adrianntz/Proiect-Stabilizator-ERS/README.md

# Proiect-Stabilizator-ERS
Proiect universitar creeat cu scopul de a studia proiectarea unui stabilizator de tensiune cu element de reglaj serie.
