adrianntz/Proiect-Stabilizator-ERS/Schematics/Schematic.jpg

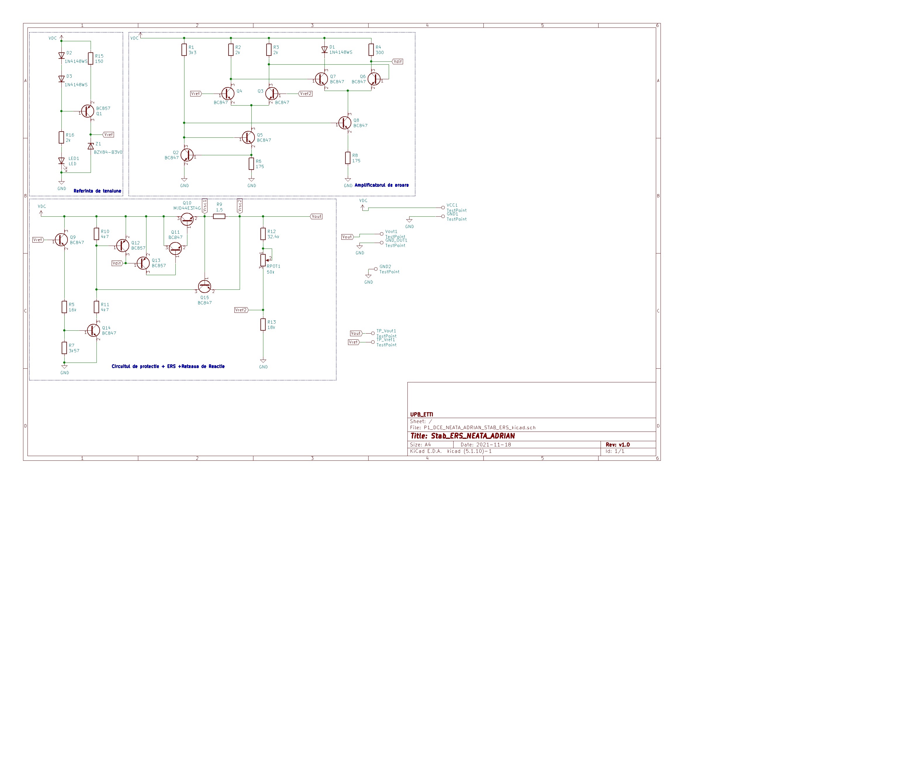
Schematics/Schematic.jpg
