adrianntz/Proiect-Stabilizator-ERS/Bill_of_materials/BOM si cerinte tehnologice.pdf

Componenta | Footprint | Power rating[mW] | Valoare | Producator | Pret unitar[L ei] | Pret total [Lei] | Componenta aleasa
D2,D3 | SOD-323FL | 200 | PN-Diode | ONSEMI | 1.38 | 6.9 | 1N4148WS – (https://ro.farnell.com/on-semiconductor/1n4148ws/diode-small-signal-75v-sod-323f/dp/2453269?st=1n4148) 200mW
T1 | SOT-23 | 250 | PNP | MULTICOMP PRO | 0.56 | 2.8 | BC857 – 250mW (https://ro.farnell.com/multicomp/bc857/transistor-pnp-0-1a-45v-sot23/dp/1798067?st=bc857)
R16 | 0805 | 125 | 30k | PANASONIC | 0.5 | 5 | ERJ6ENF3002V – 30kohm-125mW (https://ro.farnell.com/panasonic/erj6enf3002v/res-30k-1-0-125w-0805-thick-film/dp/2303701)
R15 | 0805 | 125 | 100 | MULTICOMP PRO | 1.65 | 16.5 | MCTC0525B1000T5 G - SMD 100 ohm, ± 0.1% (https://ro.farnell.com/multicomp-pro/mctc0525b1000t5g/res-100r-0-1-0-125w-0805-thin/dp/1575573) 125mW
Z1 | 3V | 125 | 3.0V | NEXPERIA | 1.18 | 5.75 | BZX84-B3V0,215 – Zener 3 V, 250 mW (https://ro.farnell.com/nexperia/bzx84-b3v0-215/zener-diode-0-25w-3v-sot-23/dp/2575187?st=BZX84-B3V0,215)
R1 | 0805 | 500 | 3.3k | VISHAY | 1.55 | 15.5 | CRCW08053K30FK EAHP -3.3kohmi (https://ro.farnell.com/vishay/crcw08053k30fkeahp/res-3k3-1-0-5w-0805-thick-film/dp/1738966) 500mW
R2 | 0805 | 125 | 2k | MULTICOMP PRO | 0.05 | 0.5 | MCWR08X2001FTL - 2 kohm, ± 1% 125mW (https://ro.farnell.com/multicomp/mcwr08x2001ftl/res-2k-1-0-125w-0805-thick-film/dp/2447622)
R3 | 0805 | 125 | 2k | MULTICOMP PRO | | | MCWR08X2001FTL - 2 kohm, ± 1% 125mW (https://ro.farnell.com/multicomp/mcwr08x2001ftl/res-2k-1-0-125w-0805-thick-film/dp/2447622)
R4 | 0805 | 125 | 300 | MULTICOMP PRO | 0.05 | 0.5 | MCWR08X3000FTL – 300ohmi (https://ro.farnell.com/multicomp/mcwr08x3000ftl/res-300r-1-0-125w-thick-film/dp/2447633) 125mW

R8 | 0805 | 500 | 174 | PANASONIC | 0.4 | 4 | ERJP06F1740V - P 174 ohm, ± 1% 500mW (https://ro.farnell.com/panasonic/erjp06f1740v/res-174r-1-0-5w-0805-thick-film/dp/2326739)
R6 | 0805 | 500 | 174 | PANASONIC | | | ERJP06F1740V - P 174 ohm, ± 1% 500mW (https://ro.farnell.com/panasonic/erjp06f1740v/res-174r-1-0-5w-0805-thick-film/dp/2326739)
T2 | SOT-23 | 250 | NPN | MULTICOMP PRO | | | 250mW (https://ro.farnell.com/multicomp/bc847c/transistor-npn-sot-23/dp/1574344?st=bc847)
T3 | SOT-23 | 250 | NPN | MULTICOMP PRO | | | BC847C – NPN-250mW (https://ro.farnell.com/multicomp/bc847c/transistor-npn-sot-23/dp/1574344?st=bc847)
T4 | SOT-23 | 250 | NPN | MULTICOMP PRO | | | BC847C – NPN-250mW (https://ro.farnell.com/multicomp/bc847c/transistor-npn-sot-23/dp/1574344?st=bc847)
T5 | SOT-23 | 250 | NPN | MULTICOMP PRO | | | BC847C – NPN-250mW (https://ro.farnell.com/multicomp/bc847c/transistor-npn-sot-23/dp/1574344?st=bc847)
T6 | SOT-23 | 250 | NPN | MULTICOMP PRO | | | BC847C – NPN-250mW (https://ro.farnell.com/multicomp/bc847c/transistor-npn-sot-23/dp/1574344?st=bc847)
T7 | SOT-23 | 250 | NPN | MULTICOMP PRO | | | BC847C – NPN-250mW (https://ro.farnell.com/multicomp/bc847c/transistor-npn-sot-23/dp/1574344?st=bc847)
T8 | SOT-23 | 250 | NPN | MULTICOMP PRO | | | BC847C – NPN-250mW (https://ro.farnell.com/multicomp/bc847c/transistor-npn-sot-23/dp/1574344?st=bc847)
T13 | SOT-23 | 250 | NPN | MULTICOMP PRO | | | BC847C – NPN-250mW (https://ro.farnell.com/multicomp/bc847c/transistor-npn-sot-23/dp/1574344?st=bc847)
D1 | SOD-323FL | 200 | PN-Diode | ONSEMI | 1.38 | 0 | 1N4148WS – (https://ro.farnell.com/on-semiconductor/1n4148ws/diode-small-signal-75v-sod-323f/dp/2453269?st=1n4148) 200mW
0.65 | 7.15 | BC847C – NPN-

T10 | TO-252 (DPAK) | 200 | NPN-Power | ONSEMI | 4,85 | 24.2 5 | MJD44E3T4G -BJT (https://ro.farnell.com/on-semiconductor/mjd44e3t4g/transistor-npn-80v-10a-to-252/dp/2727980) NPN 20W SMD
P1 | :Potentiometer_ Vishay_TS53YL_ Vertical | 250 | 50k | VISHAY | 7.58 | 7.58 | TS53YL503MR10 VISHAY -Potenţiometru: de montare | singură tură; 50kΩ; (https://www.tme.eu/ro/details/ts53yl50k/trimere-smd-cu-o-singura-tura/vishay/ts53yl503mr10/)
R12 | 0805 | 100 | 32.4k | Holsworthy-TE connectivity | 2.76 | 27.6 | 1676305-3 -r, 32.4 kohm, ± 0.1% (farnell.com) (https://ro.farnell.com/holsworthy-te-connectivity/1676305-3/res-32k4-0-1-0-1w-0805-thin-film/dp/2992061)
R13 | 0805 | 100 | 18k | WALSIN | 0.68 | 6.8 | WF08U1802BTL -Walsin - SMD Chip Resistor, 18 kohm, ± 0.1% (farnell.com) (https://ro.farnell.com/walsin/wf08u1802btl/res-18k-0-1-100v-0805-thin-film/dp/2502875)
| | | | | | | - Multicomp Pro -SMD Chip Resistor, 4.7 kohm, ± 1% (farnell.com) (https://ro.farnell.com/multicomp/mcwr08x4701ftl/res-4k7-1-0-125w-0805-thick-film/dp/2447672) 125mW Thick Film
R11 | 0805 | 125 | 4.7k | | | | MCWR08X4701FTL - Multicomp Pro -SMD Chip Resistor, 4.7 kohm, ± 1% (farnell.com) (https://ro.farnell.com/multicomp/mcwr08x4701ftl/res-4k7-1-0-125w-0805-thick-film/dp/2447672) 125mW Thick Film
R10 | 0805 | 125 | 4.7k | MULTICOMP PRO | 0.05 | 0.5 | MCWR08X4701FTL

R5 | 0805 | 125 | 16k | PANASONIC | 1.85 | 18.5 | ERA6AEB163V -Panasonic - SMD Chip Resistor, 16 kohm, ± 0.1% (farnell.com)Thin (https://ro.farnell.com/panasonic/era6aeb163v/res-16k-0-1-0-125w-0805-metal/dp/1670243?st=era6aeb163v) Film
R7 | 0805 | 100 | 3.57k | TT ELECTRONICS | 1.76 | 1.76 | PCF0805R -3K57BT1 - Tt Electronics / Welwyn - SMD Chip Resistor, 3.57 kohm, ± 0.1% 100mW (https://ro.farnell.com/tt-electronics-welwyn/pcf0805r-3k57bt1/res-3k57-0-1-0-1w-0805-thin-film/dp/1353271) Thin Film
R9 | 0805 | 500 | 1.5 | | 0.43 | 4.30 | ERJUP6J1R5V -Panasonic - SMD Chip Resistor, 1.5 ohm, ± 5% (farnell.com) (https://ro.farnell.com/panasonic/erjup6j1r5v/res-1r5-5-0-5w-0805-thick-film/dp/3598234) Thick Film
T9 | SOT -23 | 250 | NPN | MULTICOMP PRO | 0.65 | 0 | BC847C – NPN -250mW (https://ro.farnell.com/multicomp/bc847c/transistor-npn-sot-23/dp/1574344?st=bc847)
T11 | SOT -23 | 250 | NPN | MULTICOMP PRO | 0.65 | 0 | BC847C – NPN -250mW (https://ro.farnell.com/multicomp/bc847c/transistor-npn-sot-23/dp/1574344?st=bc847)
T12 | SOT -23 | 250 | PNP | MULTICOMP PRO | 0.56 | 0 | BC857 – 250mW (https://ro.farnell.com/multicomp/bc857/transistor-pnp-0-1a-45v-sot23/dp/1798067?st=bc857)
T13 | SOT -23 | 250 | PNP | MULTICOMP PRO | 0.56 | 0 | BC857 – 250mW (https://ro.farnell.com/multicomp/bc857/transistor-pnp-0-1a-45v-sot23/dp/1798067?st=bc857)
T1 | SOT -23 | 250 | NPN | MULTICOMP PRO | 0.65 | 0 | BC847C – NPN -250mW (https://ro.farnell.com/multicomp/bc847c/transistor-npn-sot-23/dp/1574344?st=bc847)

T15 | SOT -23 | 250 | NPN | MULTICOMP PRO | 0.65 | 0 | BC847C – NPN -250mW (https://ro.farnell.com/multicomp/bc847c/transistor-npn-sot-23/dp/1574344?st=bc847)
LED1 | 0805 | 62.5mW | 20mA,2.2V | KINGBRIGHT | 0.95 | 4.75 | KPHCM -2012SGC -T - Kingbright - LED, Low Power, Green (farnell.com) (https://ro.farnell.com/kingbright/kphcm-2012sgc-t/led-0805-green-25mcd-568nm/dp/1686074?st=led%200805%20green)

# Cerinte tehnologice:

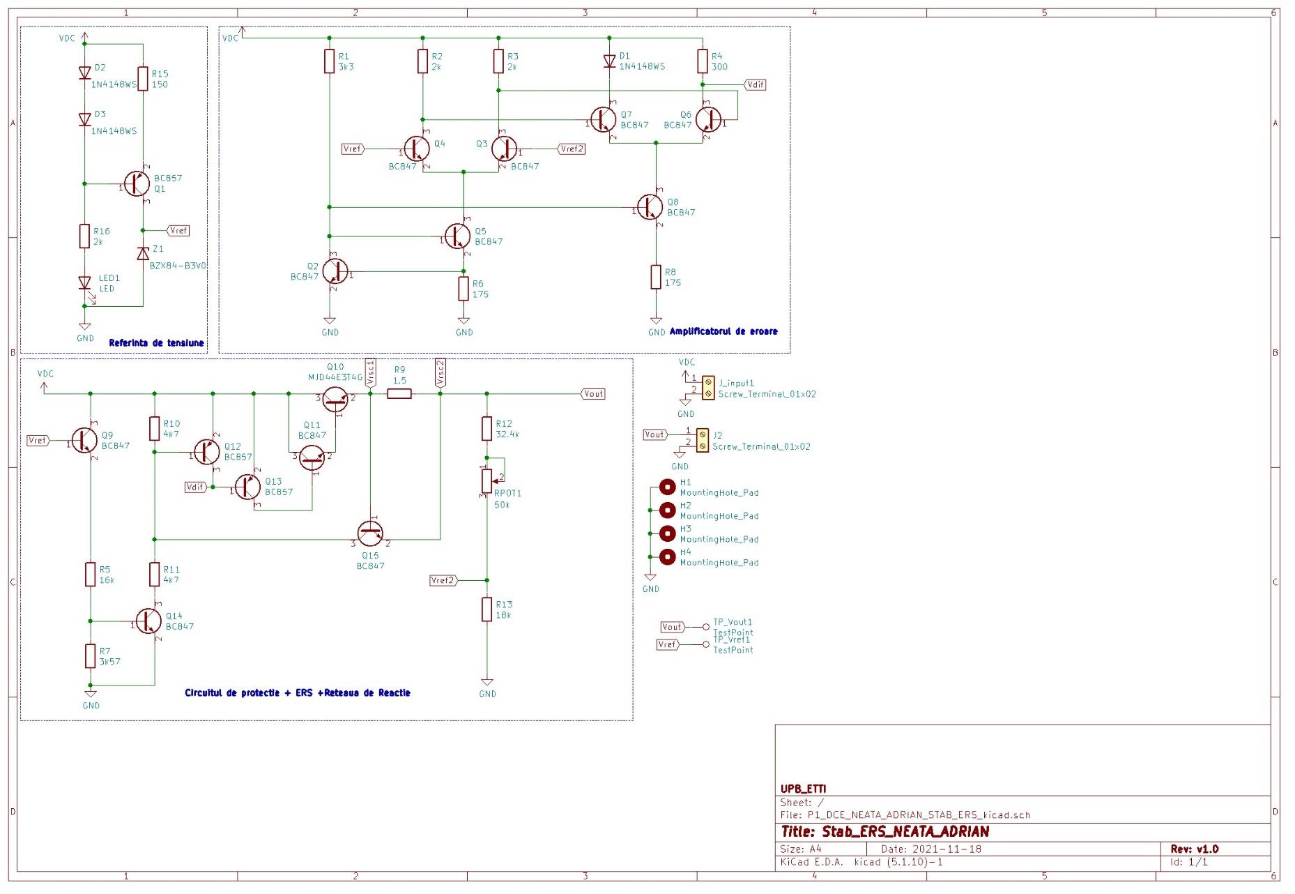
[picture p15: figure]

Schematic:

PCB-ul fizic in 3D view:

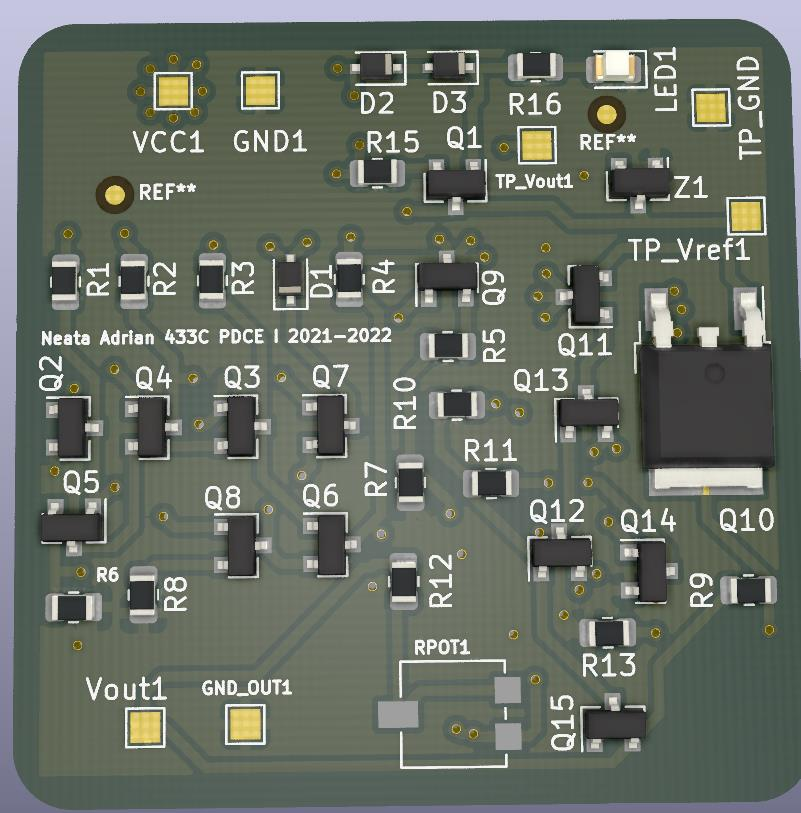
[picture p16: figure]

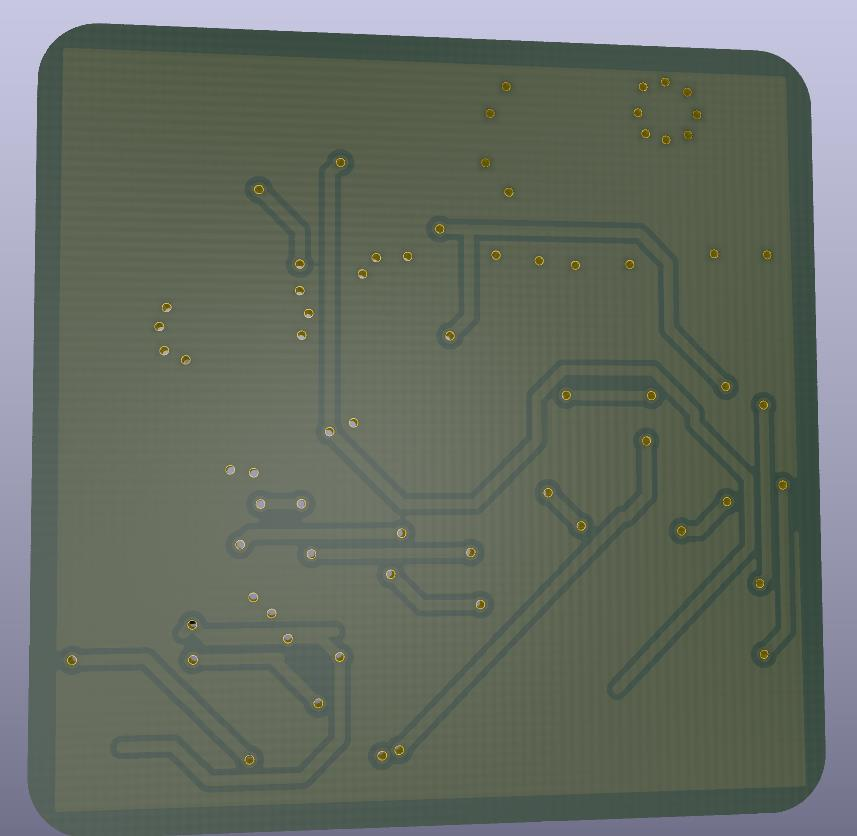
[picture p17: figure]

Dimensiunile PCB: 40mm x 40mm;

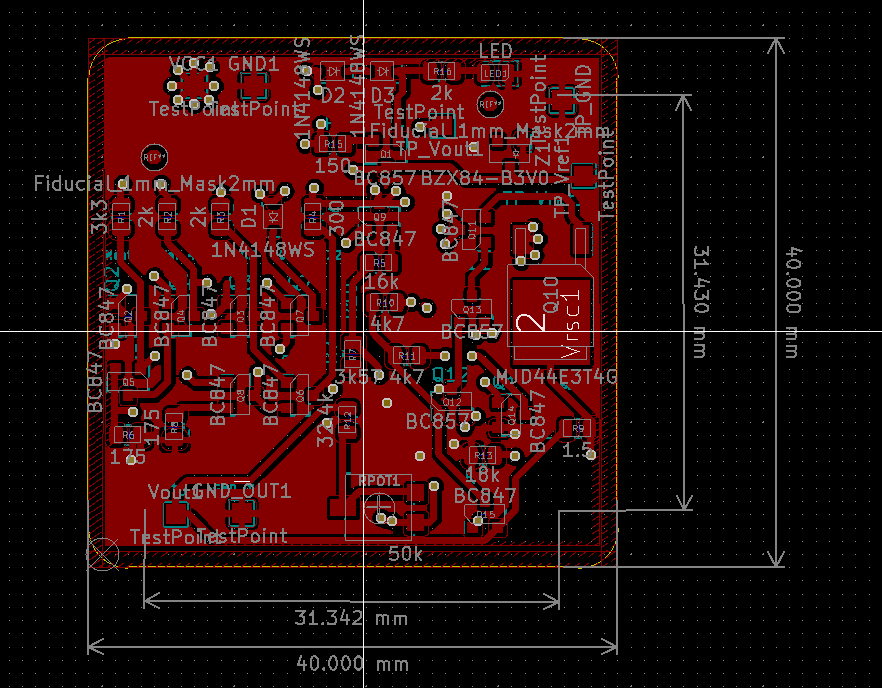
[picture p18: figure]

Material FR4, dublu strat/ grosimea foliei de cupru 18 μm, grosimea plăcii 1,5 mm;

Originea (punctul de coordonate (0,0)) va fi plasat în colţul din stânga-jos al plăcii de cablaj imprimat, astfel toate elementele proiectului vor avea coordonate pozitive;

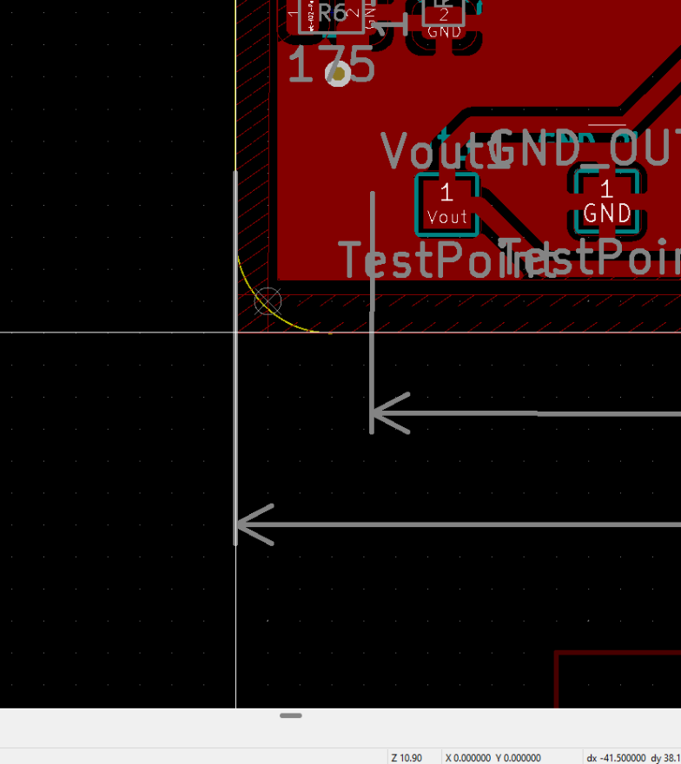
[picture p19: figure]
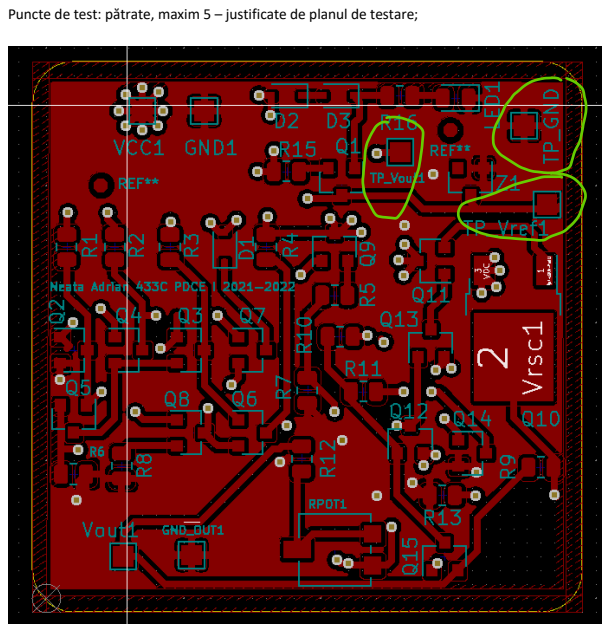
[picture p20: page 12]

Puncte de test: pătrate, maxim 5 – justificate de planul de testare;

Faţă de marginea plăcii, se va păstra o gardare („clearance”) de 1,2 mm; aici nu vor fi plasate componente, trasee, texte, etc.;

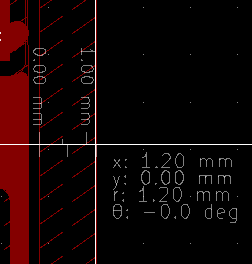
[picture p21: figure]

S-au introdus keep-out areas la marginea placii, avand lungime de 1.2mm

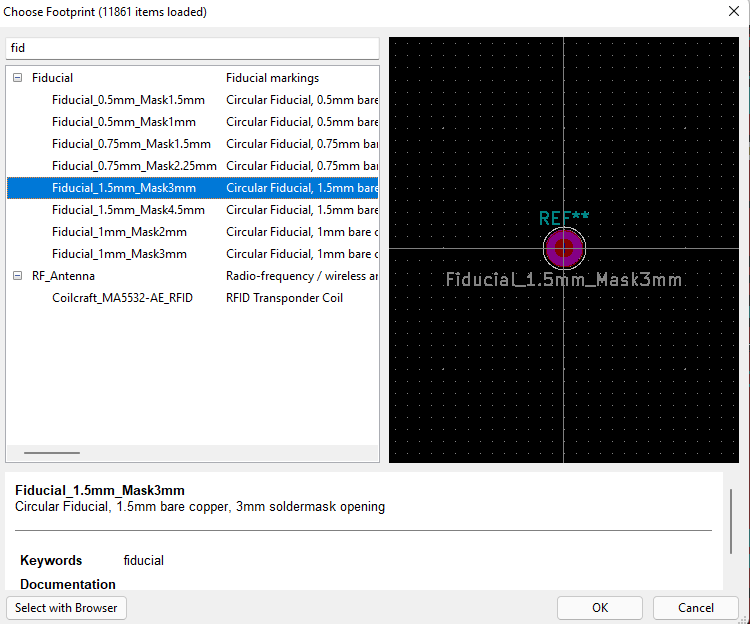
[picture p22: figure]

Placa va fi prevăzută cu 2 markeri fiduciali globali pe layerul TOP, la distanța de 200 mil față de marginea plăcii, plasați convenabil; acești markeri vor exista și pe layerul Solder Paste Top (suprapuși peste cei de pe TOP); vor fi utilizați în momentul alinierii șablonului cu placa. Marcajul fiducial va fi un cerc de diametru minim 1mm pe layerul respectiv, aflat într-un spațiu circular de diametru minim dublu față de cercul interior, în care nu se va afla nimic pe nici un layer;

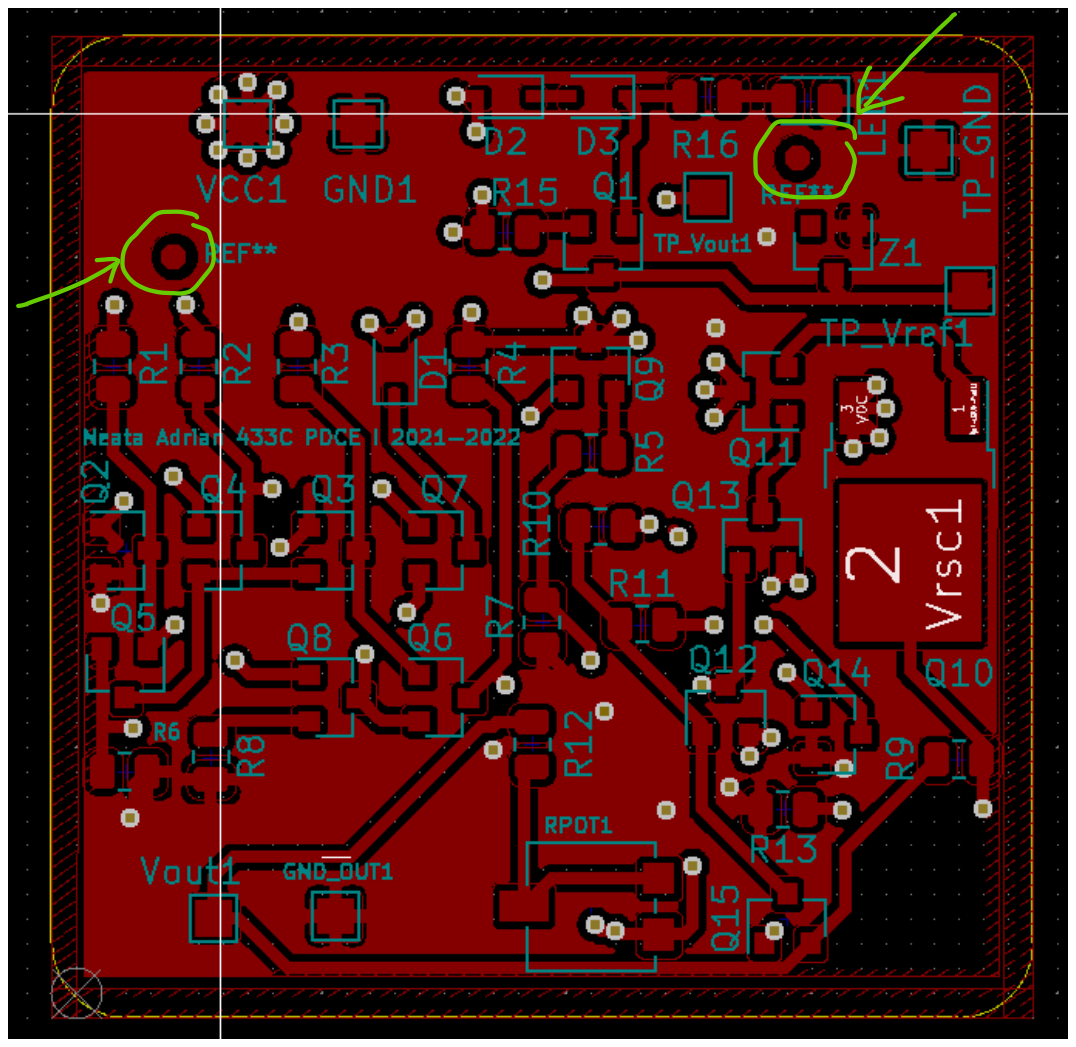
[picture p23: page 14]

Curent de sute de mA - 20 mil;

Găurile de trecere pentru semnale (vias-uri) vor avea diametrul de 0,4 mm.

Spaţierea, în toate cazurile, va fi de 12 mil.

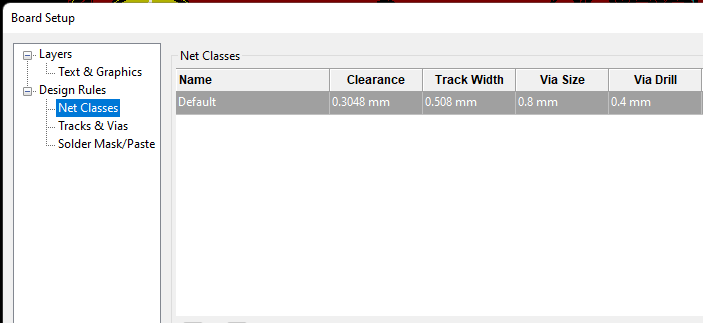
[picture p24: figure]

Fisierele Gerber:

Conturul plăcii (board outline);

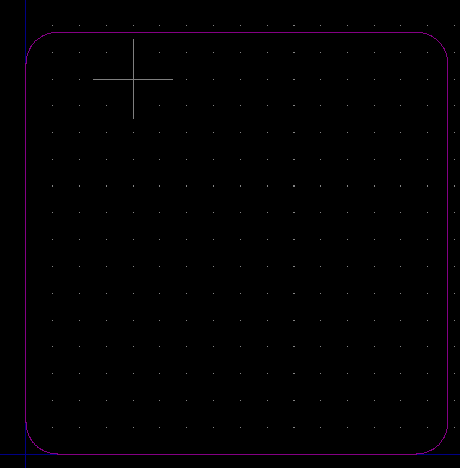
[picture p25: figure]

Layer electric TOP;

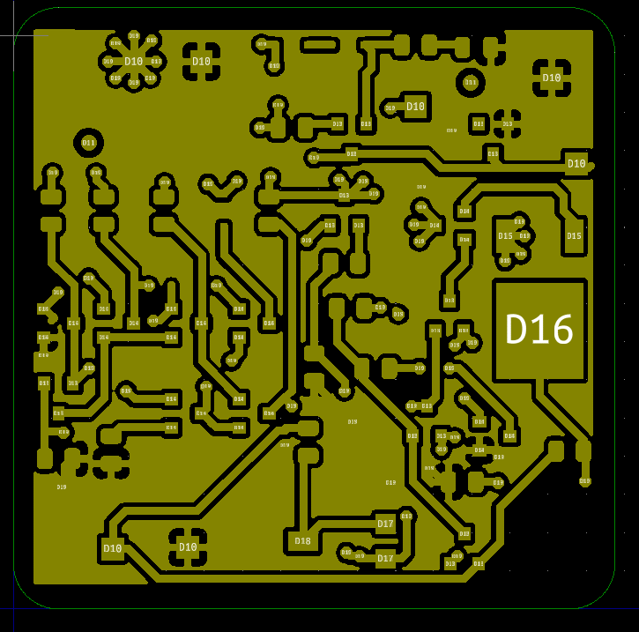
[picture p26: figure]

Layer electric BOTTOM;

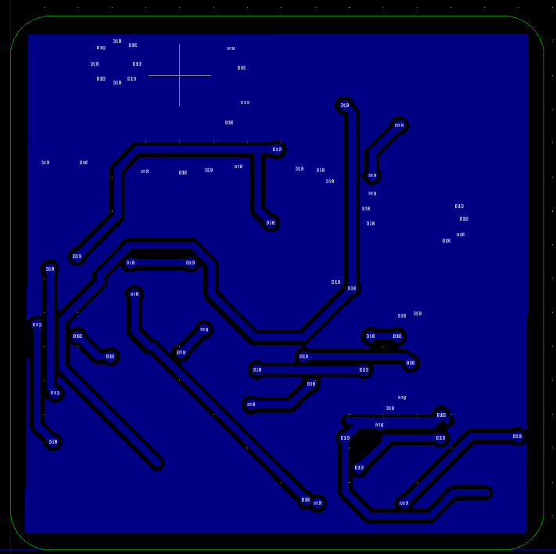
[picture p27: figure]

Layer neelectric Mască de inscripţionare (Silk Screen Top);

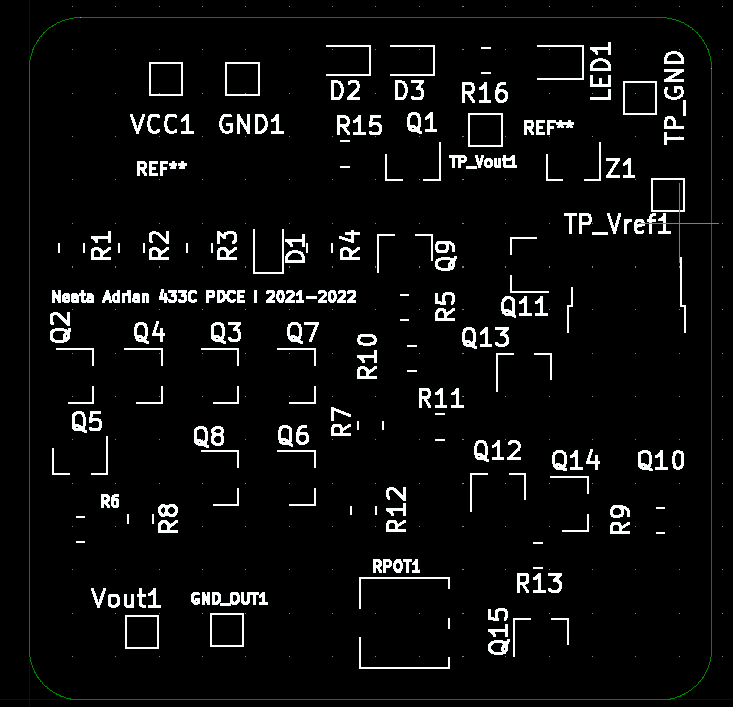
[picture p28: figure]

Layer neelectric Mască de protecţie (Solder Mask Top și Bottom);

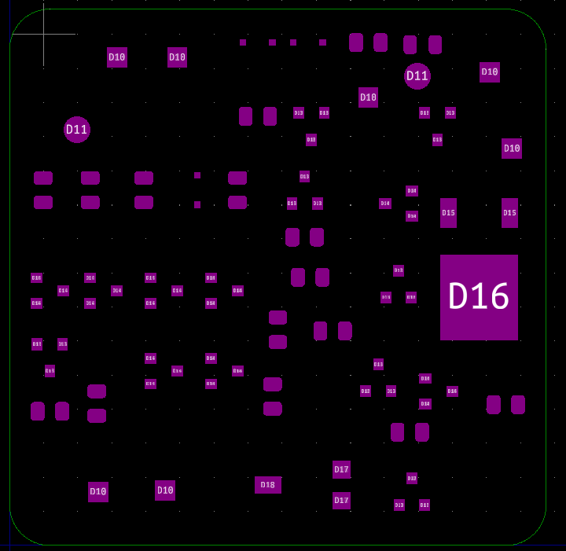
[picture p29: figure]

Layer neelectric Şablon (Solder Paste Top);

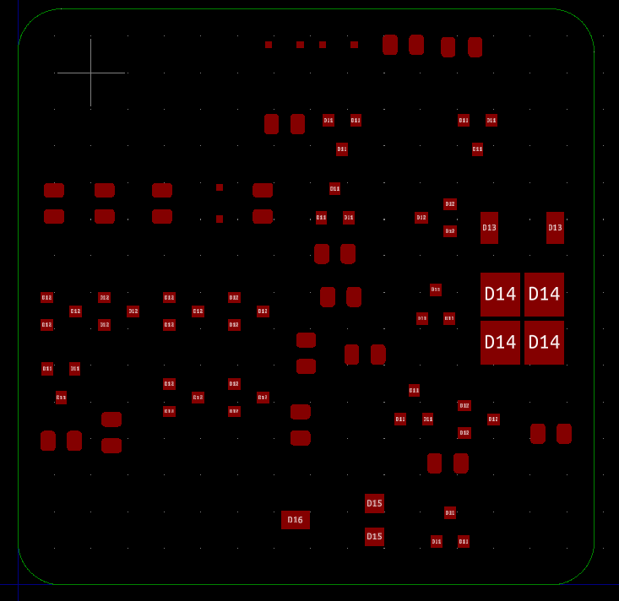
[picture p30: figure]

Fabrication

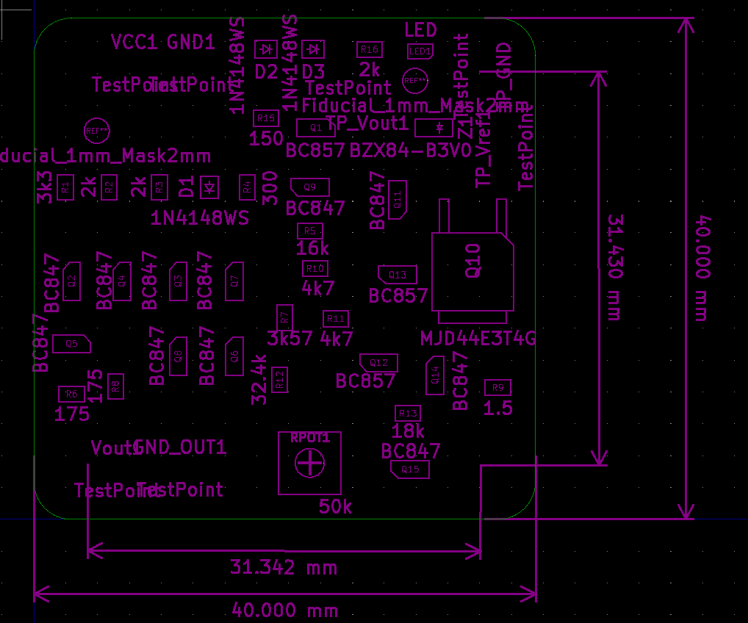
[picture p31: figure]

Drill map:

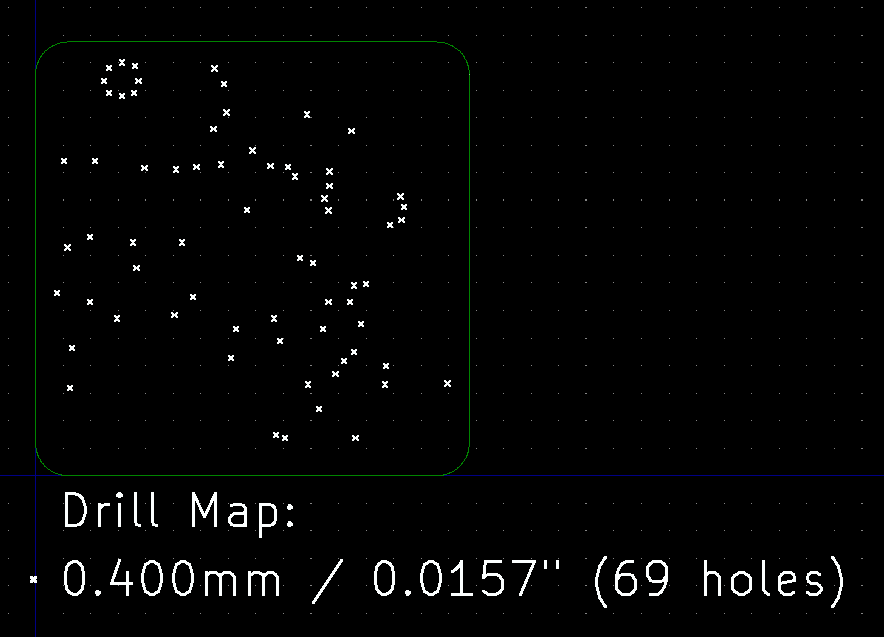
[picture p32: figure]
