adrianntz/Proiect-Stabilizator-ERS/Layout/Proiect_Kicad/P1_DCE_NEATA_ADRIAN_STAB_ERS_kicad.kicad_pcb

## KiCad design Layout/Proiect_Kicad/P1_DCE_NEATA_ADRIAN_STAB_ERS_kicad.kicad_pcb (2022-06-09)

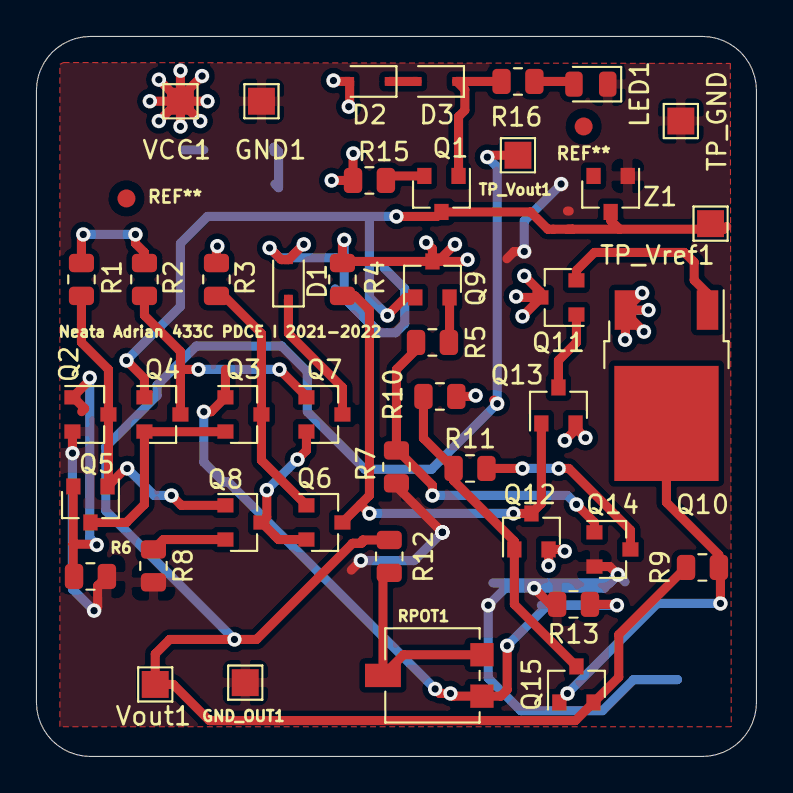
[picture p33: board P1_DCE_NEATA_ADRIAN_STAB_ERS_kicad.kicad_pcb from above]

Board: 2 copper layers, 40.0 x 40.0 mm, 43 parts (0 on the bottom side), 26 nets.

Parts:
D1, D2, D3: 1N4148WS; D_SOD-323F
GND1: TestPoint; TestPoint_Pad_1.5x1.5mm
GND_OUT1: TestPoint; TestPoint_Pad_1.5x1.5mm
LED1: LED; LED_0805_2012Metric
Q1, Q12, Q13: BC857; SOT-23
Q2, Q3, Q4, Q5, Q6, Q7, Q8, Q9, Q11, Q14, Q15: BC847; SOT-23
Q10: MJD44E3T4G; TO-252-2
R1: 3k3; R_0805_2012Metric
R2, R3, R16: 2k; R_0805_2012Metric
R4: 300; R_0805_2012Metric
R5: 16k; R_0805_2012Metric
R6, R8: 175; R_0805_2012Metric
R7: 3k57; R_0805_2012Metric
R9: 1.5; R_0805_2012Metric
R10, R11: 4k7; R_0805_2012Metric
R12: 32.4k; R_0805_2012Metric
R13: 18k; R_0805_2012Metric
R15: 150; R_0805_2012Metric
RPOT1: 50k; Potentiometer_Vishay_TS53YL_Vertical
TP_GND: TestPoint; TestPoint_Pad_1.5x1.5mm
TP_Vout1: TestPoint; TestPoint_Pad_1.5x1.5mm
TP_Vref1: TestPoint; TestPoint_Pad_1.5x1.5mm
VCC1: TestPoint; TestPoint_Pad_1.5x1.5mm
Vout1: TestPoint; TestPoint_Pad_1.5x1.5mm
Z1: BZX84-B3V0; D_SOT-23_ANK

Connections:
GND: GND1.1, GND_OUT1.1, LED1.1, Q2.2, Q14.2, R6.2, R7.2, R8.2, R13.2, TP_GND.1, Z1.2
unnamed: D1.1, Q7.3
unnamed: D2.1, D3.2
unnamed: D3.1, Q1.1, R16.1
unnamed: LED1.2, R16.2
unnamed: Q1.2, R15.2
unnamed: Q2.1, Q5.2, R6.1
unnamed: Q2.3, Q5.1, Q8.1, R1.2
unnamed: Q3.2, Q4.2, Q5.3
unnamed: Q3.3, Q6.1, R3.2
unnamed: Q4.3, Q7.1, R2.2
unnamed: Q6.2, Q7.2, Q8.3
unnamed: Q8.2, R8.1
unnamed: Q9.2, R5.1
unnamed: Q10.1, Q11.2
unnamed: Q11.1, Q13.3
unnamed: Q12.1, Q15.3, R10.2, R11.1
unnamed: Q14.1, R5.2, R7.1
unnamed: Q14.3, R11.2
unnamed: R12.2, RPOT1.1, RPOT1.2
VDC: D1.2, D2.2, Q9.3, Q10.3, Q11.3, Q12.2, Q13.2, R1.1, R2.1, R3.1, R4.1, R10.1, R15.1, VCC1.1
Vdif: Q6.3, Q12.3, Q13.1, R4.2
Vout: Q15.2, R9.1, R12.1, TP_Vout1.1, Vout1.1
Vref: Q1.3, Q4.1, Q9.1, TP_Vref1.1, Z1.1
Vref2: Q3.1, R13.1, RPOT1.3
Vrsc1: Q10.2, Q15.1, R9.2
